btoconnor/m2-upgrades/case_light/m2-led-holder.stl

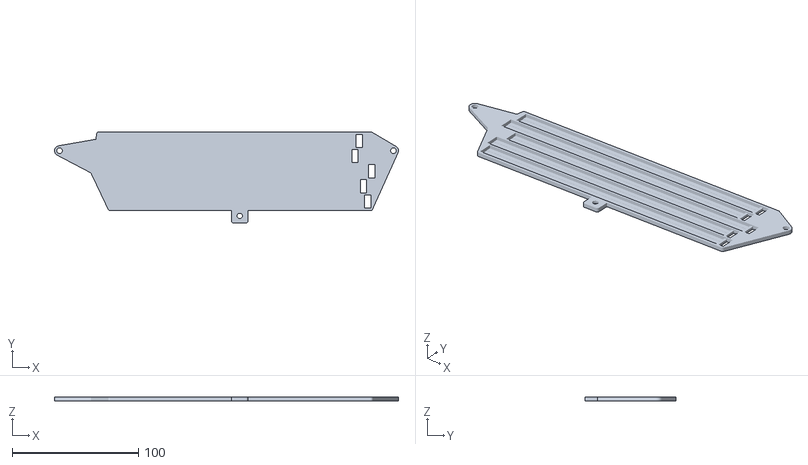
[picture p1: CAD file, 2022-11-24]
case_light/m2-led-holder.stl
273.0 x 72.5 x 3.00
